mdion1/NoteDector_PCBA/ProgrammingBed/ProgrammingBed.kicad_pcb

## KiCad design ProgrammingBed/ProgrammingBed.kicad_pcb (2024-11-25)

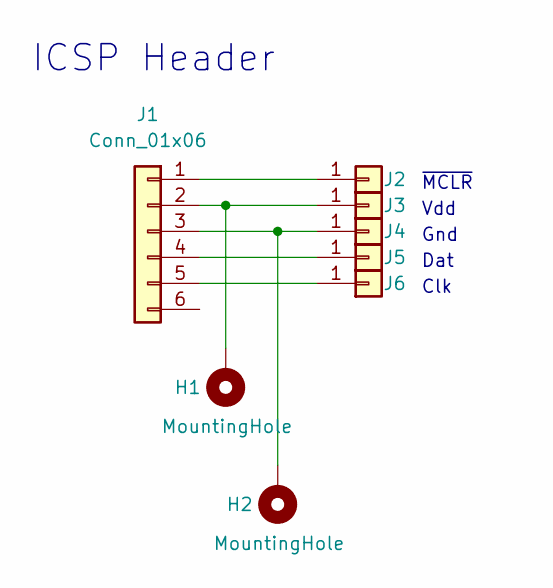
[picture p1: schematic ProgrammingBed.kicad_sch]

Parts:
H1, H2: MountingHole; PinHeader_1x01_D1.3mm_Pad2mm
J1: Conn_01x06; PinHeader_1x06_P2.54mm_Vertical
J2, J3, J4, J5, J6: Conn_01x01; PogoPin; Part Number 0985-1-15-20-71-14-11-0

Connections:
unnamed: H1.1, J1.2, J3.1
unnamed: H2.1, J1.3, J4.1
unnamed: J1.1, J2.1
unnamed: J1.4, J5.1
unnamed: J1.5, J6.1

Notes on the sheet:
ICSP Header
~{MCLR}
Dat
Vdd
Clk
Gnd

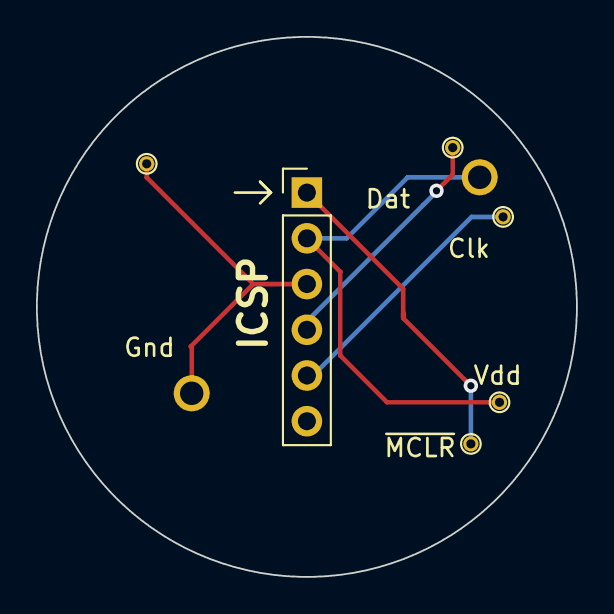
[picture p2: board ProgrammingBed.kicad_pcb from above]

Board: 2 copper layers, 30.0 x 30.0 mm, 8 parts (0 on the bottom side), 5 nets.
