mdion1/NoteDector_PCBA/NoteDetector/NoteDetector.kicad_pcb

## KiCad design NoteDetector/NoteDetector.kicad_pcb (2024-11-25)

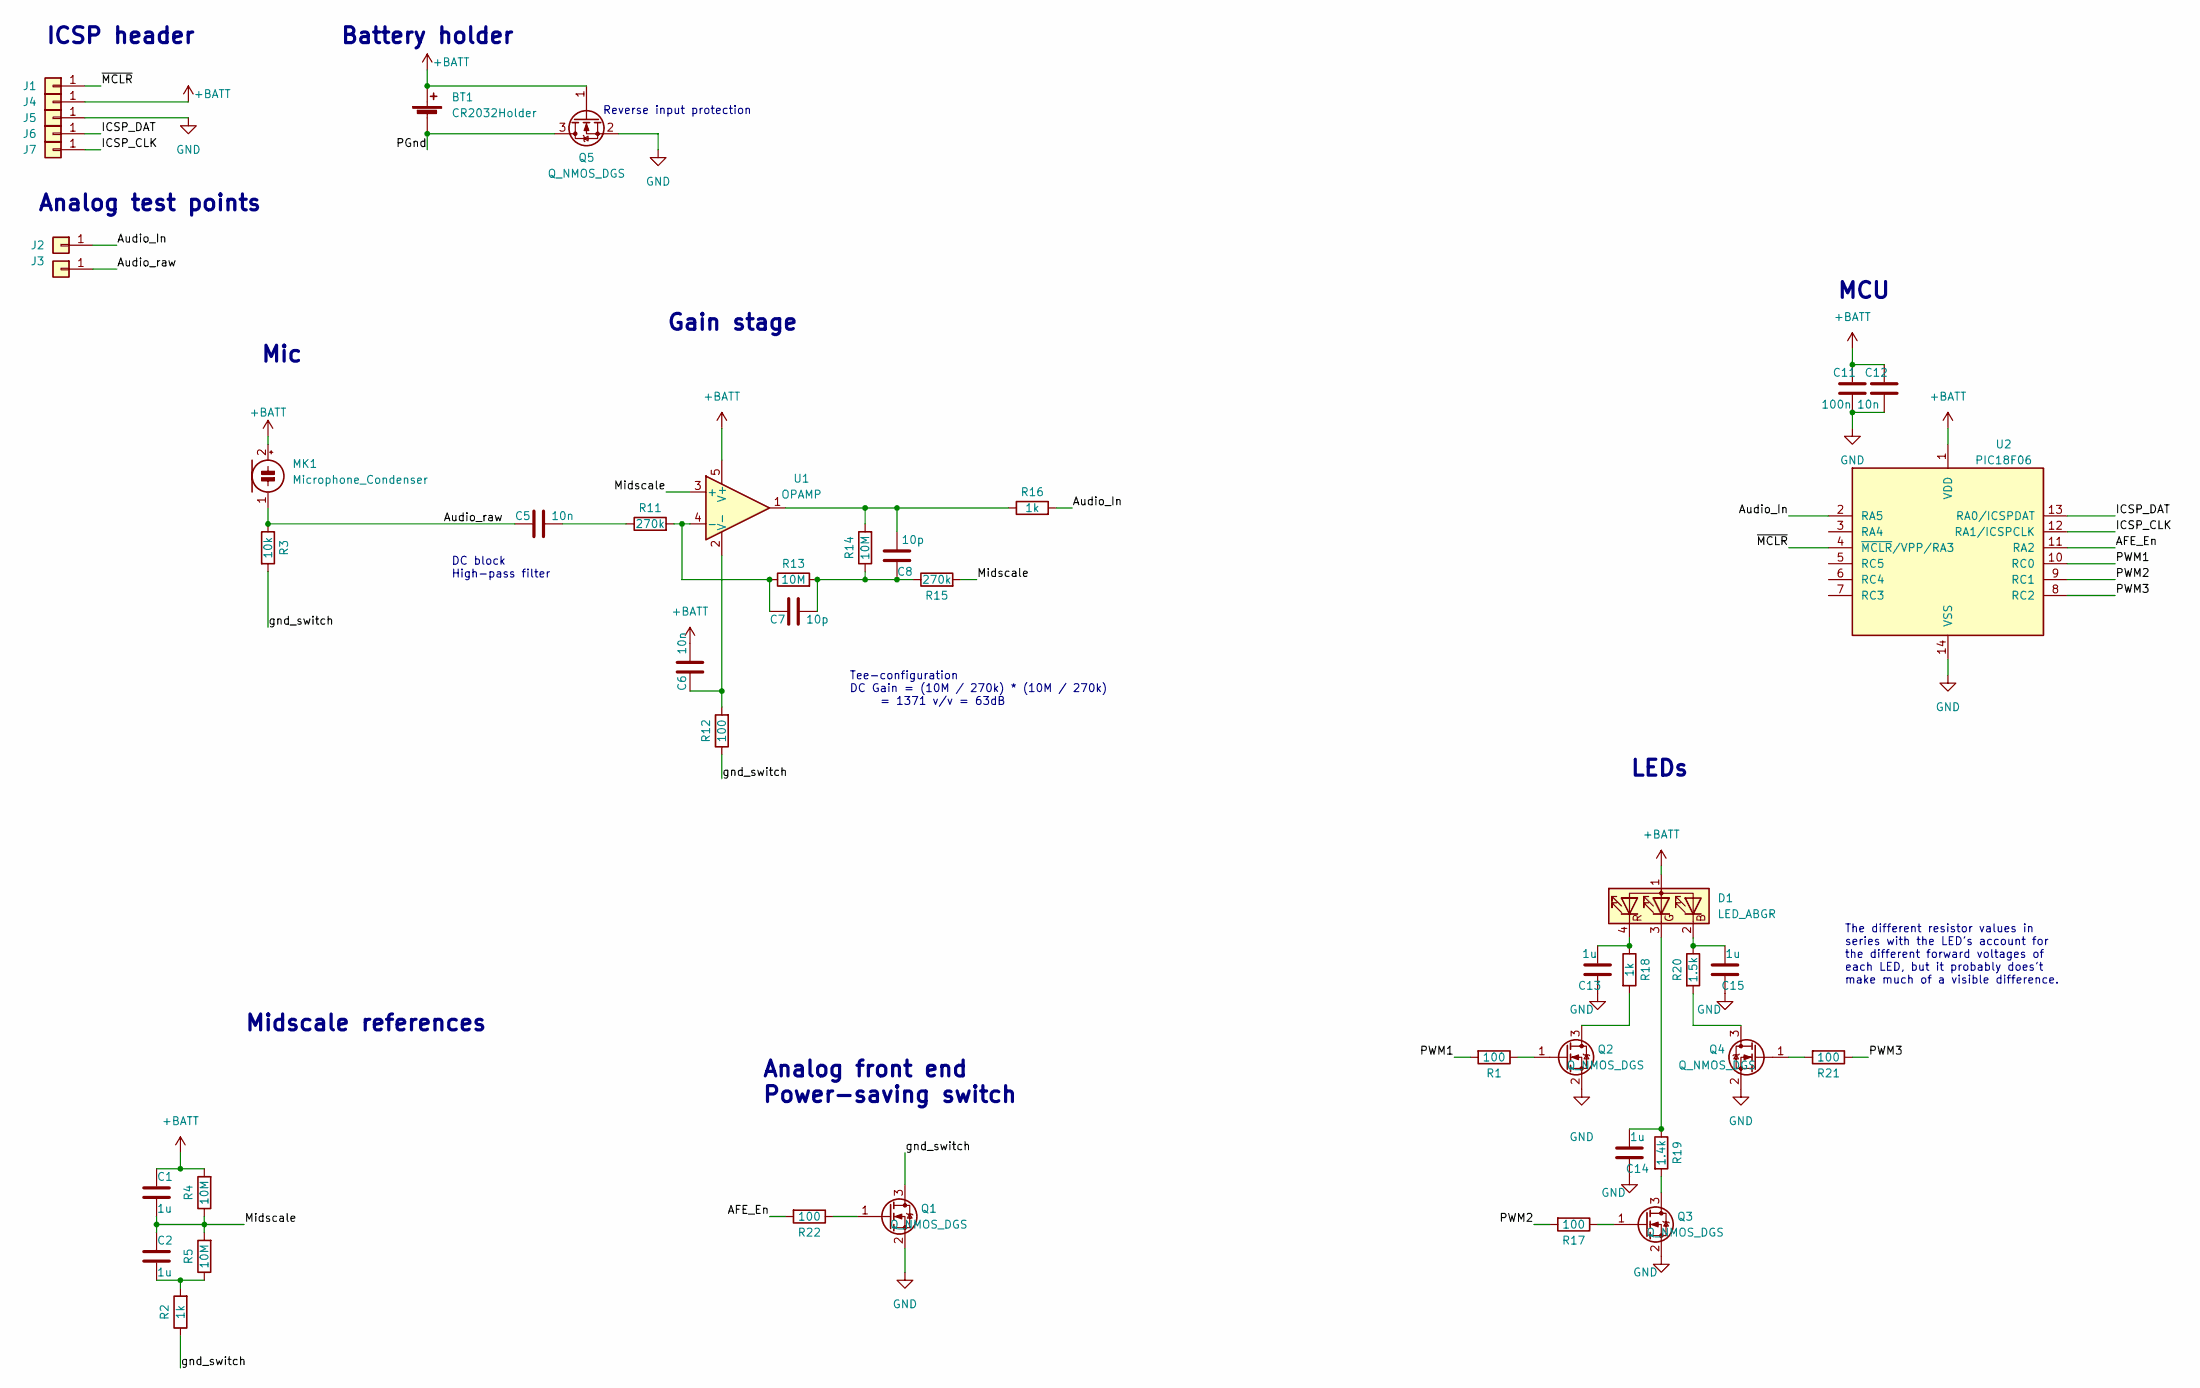
[picture p3: schematic NoteDetector.kicad_sch]

Parts:
BT1: CR2032Holder; BH-25C-1; Part Number BH-25C-1
C1, C2, C13, C14, C15: 1u; C_0603_1608Metric; Part Number CL10A105KO8NNND
C5, C6, C12: 10n; C_0603_1608Metric; Part Number 0603B103J500CT
C7, C8: 10p; C_0603_1608Metric; Part Number 0603N100J500CT
C11: 100n; C_0603_1608Metric; Part Number CL10B104JB8NNNC
D1: LED_ABGR; PLCC-4; Part Number CLMVC-FKA-CL1D1L71BB7C3C3
J1, J2, J3, J4, J5, J6, J7: Conn_01x01; TestPoint_Pad_D1.0mm; Part Number none
MK1: Microphone_Condenser; ElectretCondenserMic_SMT_MO063602-1; Part Number MO063602-1
Q1, Q2, Q3, Q4, Q5: Q_NMOS_DGS; SOT-23; Part Number T2N7002AK,LM
R1, R12, R17, R21, R22: 100; R_0603_1608Metric; Part Number CRG0603F100R
R2, R16, R18: 1k; R_0603_1608Metric; Part Number CRCW06031K00FKEAC
R3: 10k; R_0603_1608Metric; Part Number ERJ-3GEYJ103V
R4, R5, R13, R14: 10M; R_0603_1608Metric; Part Number WR06W1005FTL
R11, R15: 270k; R_0603_1608Metric; Part Number RC0603FR-07270KL
R19: 1.4k; R_0603_1608Metric; Part Number CR0603-FX-1401ELF
R20: 1.5k; R_0603_1608Metric; Part Number RC0603JR-131K5L
U1: OPAMP; SOT-23-5; Part Number MCP6061T-E/OT or MCP6231T-E/OT
U2: PIC18F06; TSSOP-14_4.4x5mm_P0.65mm; Part Number PIC18F06Q41-E/ST or PIC18F06Q40-E/ST

Connections:
+BATT: BT1.1 (+), C1.2, C6.1, C11.1, C12.1, D1.1 (A), J4.1, MK1.2 (+), Q5.1 (G), R4.2, U1.5 (V+), U2.1 (VDD)
/AFE_En: R22.2, U2.11 (RA2)
/Audio_In: J2.1, R16.2, U2.2 (RA5)
/Audio_raw: C5.1, J3.1, MK1.1 (-), R3.1
/ICSP_CLK: J7.1, U2.12 (RA1/ICSPCLK)
/ICSP_DAT: J6.1, U2.13 (RA0/ICSPDAT)
/Midscale: C1.1, C2.2, R4.1, R5.2, R15.2, U1.3 (+)
/PGnd: BT1.2 (-), Q5.3 (D)
/PWM1: R1.2, U2.10 (RC0)
/PWM2: R17.2, U2.9 (RC1)
/PWM3: R21.1, U2.8 (RC2)
/gnd_switch: Q1.3 (D), R2.1, R3.2, R12.1
/~MCLR: J1.1, U2.4 (~MCLR/VPP/RA3)
GND: C11.2, C12.2, C13.2, C14.2, C15.2, J5.1, Q1.2 (S), Q2.2 (S), Q3.2 (S), Q4.2 (S), Q5.2 (S), U2.14 (VSS)
unnamed: C2.1, R2.2, R5.1
unnamed: C5.2, R11.1
unnamed: C7.1, C8.2, R13.2, R14.1, R15.1
unnamed: C8.1, R14.2, R16.1, U1.1
unnamed: C15.1, D1.2 (BK), R20.1
unnamed: C14.1, D1.3 (GK), R19.1
unnamed: C13.1, D1.4 (RK), R18.1
unnamed: Q1.1 (G), R22.1
unnamed: Q2.3 (D), R18.2
unnamed: Q2.1 (G), R1.1
unnamed: Q3.3 (D), R19.2
unnamed: Q3.1 (G), R17.1
unnamed: Q4.3 (D), R20.2
unnamed: Q4.1 (G), R21.2
unnamed: C7.2, R11.2, R13.1, U1.4 (-)
unnamed: C6.2, R12.2, U1.2 (V-)

Notes on the sheet:
MCU
Mic
Battery holder
Gain stage
Tee-configuration DC Gain = (10M / 270k) * (10M / 270k) = 1371 v/v = 63dB
The different resistor values in series with the LED's account for the different forward voltages of each LED, but it probably does't make much of a visible difference.
Analog front end Power-saving switch
DC block High-pass filter
Reverse input protection
LEDs
Analog test points
ICSP header
Midscale references

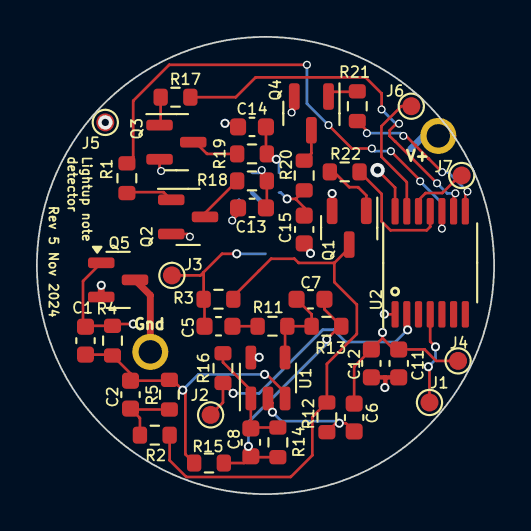
[picture p4: board NoteDetector.kicad_pcb from above]

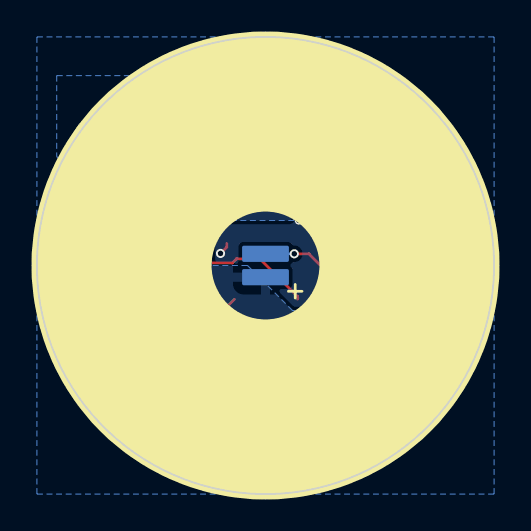
[picture p5: board NoteDetector.kicad_pcb from below]

Board: 2 copper layers, 25.4 x 25.4 mm, 45 parts (2 on the bottom side), 30 nets.
