mdion1/NoteDector_PCBA/(commit log)

2022-02-14 Initial commit: contains finished debugging test board layout
    [NoteDetector-B_Cu.gbr, NoteDetector-B_Mask.gbr, NoteDetector-B_Paste.gbr, NoteDetector-B_Silkscreen.gbr, NoteDetector-Edge_Cuts.gbr, NoteDetector-F_Cu.gbr, NoteDetector-F_Mask.gbr, NoteDetector-F_Paste.gbr]
2022-02-14 Started populating BOM
    [NoteDetector.kicad_sch]
2023-02-03 changed amp circuit
    replacing MEMS mic with electret condenser
    Todo: new microcontroller
    [NoteDetector.kicad_sch]
2023-02-08 Save work; Added a new schematic symbol for the PIC18F06Q41; new footprint for the MO063602-1 condenser mic
    [NoteDetector.kicad_sch]
2023-02-09 save work: new layout almost done
    [NoteDetector.kicad_pcb, NoteDetector.kicad_sch]
2023-02-09 rev2 board layout done
    [NoteDetector-B_Cu.gbr, NoteDetector-B_Mask.gbr, NoteDetector-B_Paste.gbr, NoteDetector-B_Silkscreen.gbr, NoteDetector-Edge_Cuts.gbr, NoteDetector-F_Cu.gbr, NoteDetector-F_Mask.gbr, NoteDetector-F_Paste.gbr]
2023-02-09 Added revision to silkscreen
    [NoteDetector-B_Cu.gbr, NoteDetector-B_Mask.gbr, NoteDetector-B_Paste.gbr, NoteDetector-B_Silkscreen.gbr, NoteDetector-Edge_Cuts.gbr, NoteDetector-F_Cu.gbr, NoteDetector-F_Mask.gbr, NoteDetector-F_Paste.gbr]
2023-02-20 Added programming bed PCB; moved PCB programming pads; added CR2032 battery holder; todo: fix silkscreen
    [NoteDetector.kicad_pcb, NoteDetector.kicad_sch, ProgrammingBed.kicad_pcb, ProgrammingBed.kicad_sch]
2023-03-20 Updated BOM, moved programming pads outside of CR2032 battery holder coverage; board layout not finished
    [NoteDetector.kicad_pcb, NoteDetector.kicad_sch]
2023-03-21 Rev 3 layout (hastily) completed!
    [NoteDetector-B_Cu.gbr, NoteDetector-B_Mask.gbr, NoteDetector-B_Paste.gbr, NoteDetector-B_Silkscreen.gbr, NoteDetector-Edge_Cuts.gbr, NoteDetector-F_Cu.gbr, NoteDetector-F_Mask.gbr, NoteDetector-F_Paste.gbr]
2023-03-21 Tweaked layout to get better clearance around programming contact
    [NoteDetector-B_Cu.gbr, NoteDetector-B_Mask.gbr, NoteDetector-B_Paste.gbr, NoteDetector-B_Silkscreen.gbr, NoteDetector-Edge_Cuts.gbr, NoteDetector-F_Cu.gbr, NoteDetector-F_Mask.gbr, NoteDetector-F_Paste.gbr]
2023-03-21 Added BOM; added programming bed rev1 layout
    [NoteDetector.kicad_sch, NoteDetector_bom_.csv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]
2024-11-25 Changelog: combined midscale references; added reverse voltage protection; moved ~MCLR programming pad to board perimeter; increased min drill/pad size
    [NoteDetector-B_Cu.gbr, NoteDetector-B_Mask.gbr, NoteDetector-B_Paste.gbr, NoteDetector-B_Silkscreen.gbr, NoteDetector-Edge_Cuts.gbr, NoteDetector-F_Cu.gbr, NoteDetector-F_Mask.gbr, NoteDetector-F_Paste.gbr]
